evisvasiu/GPRS-Weather-Station/communication.h

#include "credentials.h"   
//Serial is used for serial monitoring
//Serial1 is used for the modem communication
//Serial2 is used for the RS485 module

extern bool msgReceived;
extern int keepRunning;

extern bool enableDisplay;  
#define trigerPin 18

// Select your modem:
#define TINY_GSM_MODEM_SIM800

// Define the serial console for debug prints, if needed
#define TINY_GSM_DEBUG Serial

// Define how you're planning to connect to the internet
#define TINY_GSM_USE_GPRS true

// set GSM PIN, if any
#define GSM_PIN ""


#include <TinyGsmClient.h>
#include <PubSubClient.h>

#ifdef DUMP_AT_COMMANDS
#include <StreamDebugger.h>
StreamDebugger debugger(Serial, Serial1, Serial2);
TinyGsm modem(debugger);
#else
TinyGsm modem(Serial1);
#endif
TinyGsmClient client(modem);
PubSubClient mqtt(client);


void callback(char* topic, byte* message, unsigned int length) {
  Serial.print("Message arrived on topic: ");
  Serial.print(topic);
  Serial.print(". Message: ");
  String messageTemp;
  
  for (int i = 0; i < length; i++) {
    Serial.print((char)message[i]);
    messageTemp += (char)message[i];
  }
  keepRunning = messageTemp.toInt();
  msgReceived = true;
}

bool mqttConnect(){

  bool status = mqtt.connect("GsmClientName", mqtt_user, mqtt_pass);

  if (!status){
    Serial.print(".");
    delay(1000);
    return false;
  }

  Serial.println(" success");
  disp_txt += "Connected!";
  testdrawstyles(disp_txt, 1, enableDisplay);
  mqtt.publish(topicInit, "Started");
  mqtt.subscribe("lilygo/msgReceived",1);
  return mqtt.connected();
}

void mqttReconnect(){ 

  if(!mqtt.connected()){
    Serial.print("Recconnecting to MQTT");
    disp_txt = "Recconnecting to MQTT\n";
    testdrawstyles(disp_txt, 1, enableDisplay);
    long start_time = millis();
    while(!mqttConnect()){
      if(millis() > start_time + 40000){
        Serial.println("failed");
        Serial.println("Cannot connect to MQTT. Board will turn off in 5 seconds.");
            disp_txt = "Cannot connect to MQTT. Board will turn off in 5 seconds.";
            testdrawstyles(disp_txt, 1, enableDisplay);
        delay(5000);
        digitalWrite(trigerPin, HIGH);
      }
    }
  }
}

void communicationSetup(){
  Serial.println("Wait...");
  disp_txt = "Wait...\n";
  testdrawstyles(disp_txt, 1, enableDisplay);

  // Set GSM module baud rate and UART pins
  Serial1.begin(57600, SERIAL_8N1, MODEM_RX, MODEM_TX);
  delay(100);

  // Restart takes quite some time
  // To skip it, call init() instead of restart()
  Serial.println("Initializing modem...");
  disp_txt += "Initializing modem...\n";
  testdrawstyles(disp_txt, 1, enableDisplay);
    
  //modem.restart();
  modem.init();
  String modemInfo = modem.getModemInfo();
  Serial.print("Modem Info: ");
  Serial.println(modemInfo);
    

  #if TINY_GSM_USE_GPRS
    // Unlock your SIM card with a PIN if needed
    if ( GSM_PIN && modem.getSimStatus() != 3 ) {
        modem.simUnlock(GSM_PIN);
    }
  #endif

  Serial.print("Waiting for network...");
  disp_txt = "Waiting for network...\n";
  testdrawstyles(disp_txt, 1, enableDisplay);
  long start_time = millis();
  while (!modem.waitForNetwork()) {
    Serial.print(".");
    if (millis() > start_time + 10000){
      Serial.print("No network signal. Board will turn off in 5 seconds");
      delay(5000);
      digitalWrite(trigerPin, HIGH);    //turning of the board
    }
  }

  Serial.println(" success");

  if (modem.isNetworkConnected()){
    Serial.println("Network connected\n");
    disp_txt = "Network connected\n";
    testdrawstyles(disp_txt, 1, enableDisplay);
  }

  // GPRS connection parameters are usually set after network registration
  Serial.print(F("Connecting to "));
  Serial.print(apn);
  disp_txt += "Connecting to \n" + String(apn) + "...\n";
  testdrawstyles(disp_txt, 1, enableDisplay);
  start_time = millis();
  while (!modem.gprsConnect(apn, gprsUser, gprsPass)) {
    Serial.print(".");
    if (millis() > start_time + 10000){
      Serial.print("No APN. Board will turn off in 5 seconds");
      delay(5000);
      digitalWrite(trigerPin, HIGH);    //turning of the board
    }
  }

  if (modem.isGprsConnected()) {
    Serial.println("GPRS connected\n");
    disp_txt = "GPRS connected\n";
    testdrawstyles(disp_txt, 1, enableDisplay);
  }

  // MQTT Broker setup
  mqtt.setServer(broker, 1883);
  mqtt.setCallback(callback);

  Serial.print("Connecting to ");
  Serial.print(broker);
  disp_txt += "Connecting to " + String(broker) + "\n";
  testdrawstyles(disp_txt, 1, enableDisplay);

  mqttConnect();
  digitalWrite(13, HIGH);
}
