evisvasiu/GPRS-Weather-Station/credentials.h

// Your GPRS credentials, if any
const char apn[] = "";
const char gprsUser[] = "";
const char gprsPass[] = "";

// MQTT details
const char *broker = "";
const char *mqtt_user = "";
const char *mqtt_pass = "";

const char *topicInit = "";
