evisvasiu/GPRS-Weather-Station/(commit log)

2022-03-29 Power module
    power module mqtt
2022-03-29 minor update
    power module parameters settled in void loop()
2022-05-15 Update lilygo_sim800l_weather-station.ino
    Ading BME280 sensor
2022-05-17 Update lilygo_sim800l_weather-station.ino
    final pin address for the sensors
2022-05-18 Update lilygo_sim800l_weather-station.ino
    all sensors wired
2022-11-15 Update lilygo_sim800l_weather-station.ino
    Added timer triger to pin 34
2022-11-21 Creating separate files for each sensor and module
    Cleaning up
2022-11-22 Added UV Index device
    1. Added UV index device
    2. Replaced defitions. SerialAT with Serial 1. SerialMon with Serial
    [communication.h, json.h, utilities.h, uv.h]
2022-11-22 Update utilities.h
    Added voltage divider resistor values
2022-12-09 Update utilities.h
    battery voltage average value
2022-12-24 update triger pin
2023-06-26 Code optimisatin
    Replaced Sensor's loading tentative steps with tentative time
    [bme280.h, communication.h, credentials.h, sht30.h, utilities.h, uv.h]
2023-07-12 battery voltage
2023-07-14 Main update
    1. Replaced SHT30 library
    2. Replaced AXP192 code
    3. Implemented While loop on UV measurements.
    4. Removed Display to be added later
    [bme280.h, communication.h, ds18b20.h, json.h, sht30.h, utilities.h, uv.h, wmd.ino]
2023-07-14 update utilities.h
    battery voltage measurements
2023-07-14 major updates
    Included display activatino by a digital button
2023-07-16 Optimisation
    1. Remote control added
    2. "atLeastOneMeasurement" variable reset for continuous measuremet.
    [communication.h, json.h, sht30.h, uv.h, wmd.ino]
